anglersking/quadcopter/schematic/Altium_Design/PCB_PROJECT/rotor.DXF

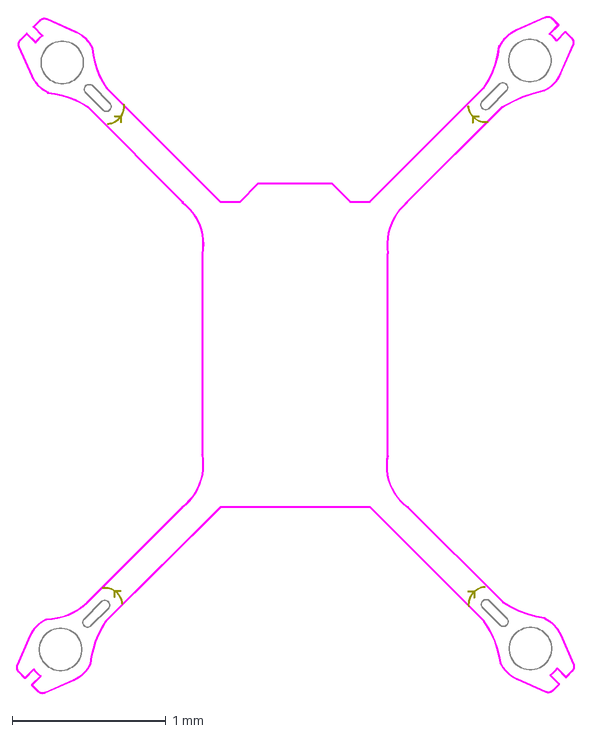
[picture p1: CAD file, 2024-02-03]
schematic/Altium_Design/PCB_PROJECT/rotor.DXF
3.63 x 4.41 mm
