anglersking/quadcopter/schematic/Altium_Design/四轴原理图/源动力-四轴 v1.9.5.pdf

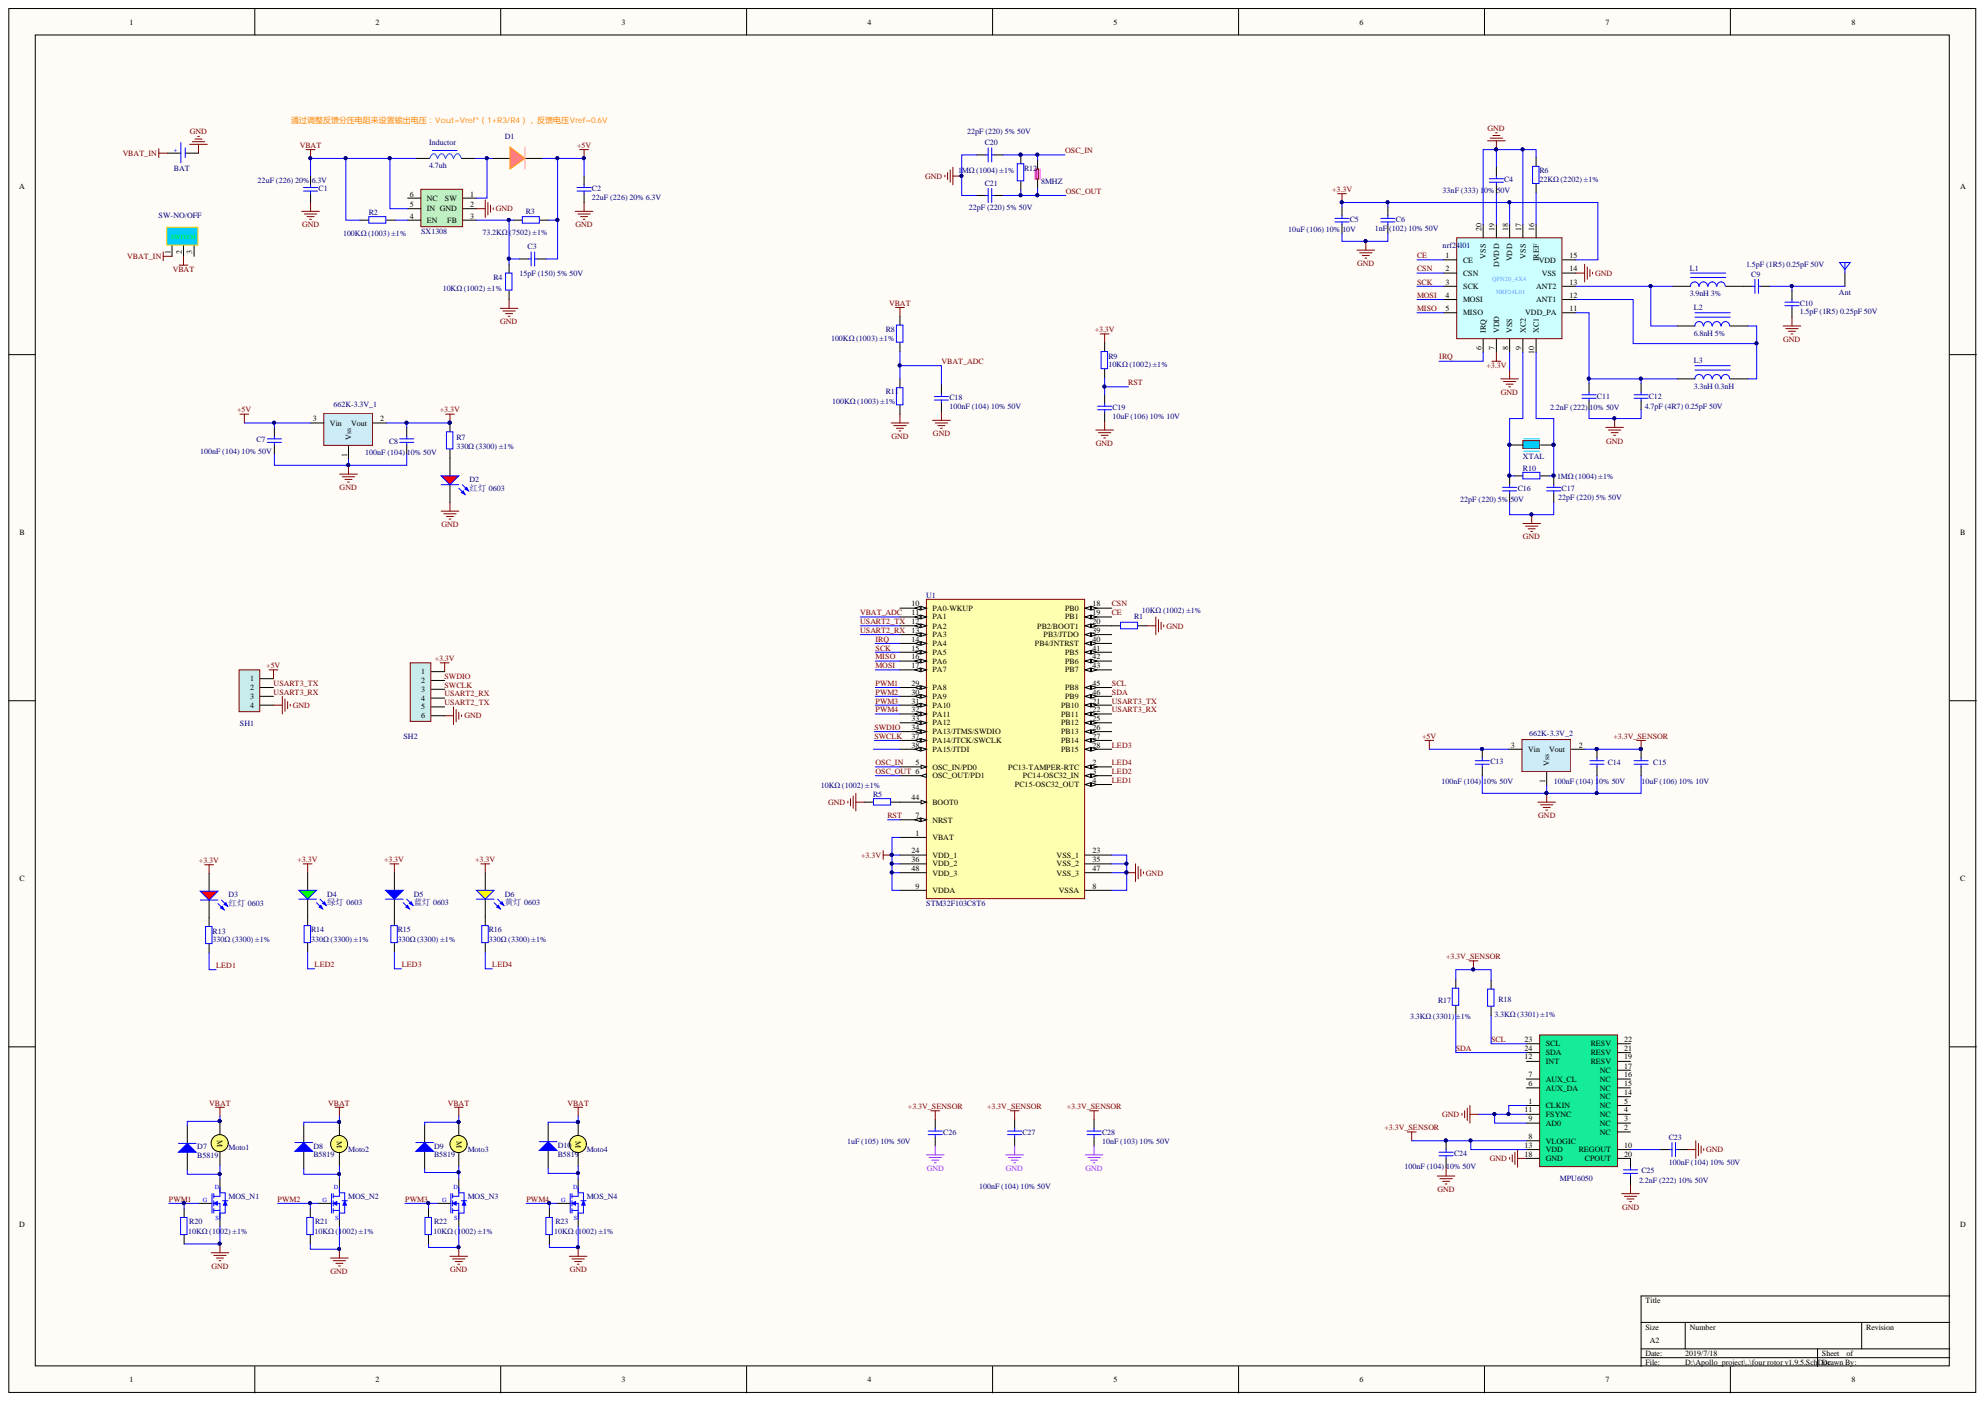
[picture p2: page 1]

通过调整反馈分压电阻来设置输出电压：Vout=Vref*（1+R3/R4），反馈电压Vref=0.6V
