anglersking/quadcopter/(list of files, drawings)

Other design files:
schematic/Altium_Design/PCB_PROJECT/cpu_core.SchDoc
schematic/Altium_Design/PCB_PROJECT/flow.SchDoc
schematic/Altium_Design/PCB_PROJECT/rotor.SchDoc
schematic/Altium_Design/PCB_PROJECT/SPL06.SchDoc
schematic/Altium_Design/自制3D元件封装库/self_schlib v1.8.6.SchLib
