anglersking/quadcopter/code/四轴飞行器/four rotor v1.8.6/four rotor/four rotor/driver/filter.h

#ifndef _filter_h_
#define _filter_h_

typedef struct
{
    float input_data[3];
    float output_data[3];
}_Butterworth_data;

typedef struct
{
    const float a[3];
    const float b[3];
}_Butterworth_parameter;

float butterworth_lpf(float now_input,_Butterworth_data *buffer, _Butterworth_parameter *parameter);


#endif
