anglersking/quadcopter/code/四轴飞行器/four rotor v1.8.6/four rotor/four rotor/driver/imath.c

#include "imath.h"

// Fast inverse square-root

float invSqrt(float x)
{
    float halfx = 0.5f * x;
    float y = x;
    long i = *(long*)&y;
    i = 0x5f3759df - (i>>1);
    y = *(float*)&i;
    y = y * (1.5f - (halfx * y * y));
    return y;
}


float my_abs(float f)
{
	if (f >= 0.0f)
	{
		return f;
	}

	return -f;
}


uint16_t  throttle_limit(uint16_t thr_in,uint16_t thr_min,uint16_t thr_max)
{
	if(thr_in<thr_min)	thr_in = thr_min;
	if(thr_in>thr_max)	thr_in = thr_max;
	
	return thr_in;
}

float direction_to_zero(float in_dat,float min_dat,float max_dat)
{
    if(in_dat>min_dat&&in_dat<max_dat)  
        in_dat = 0;
    
    return in_dat;
}

void  set_value(SI_F_XYZ *_in_data,float value)
{
    _in_data->x = value;
    _in_data->y = value;
    _in_data->z = value;
}

void _set_val(SI_F_XYZ *_out_data,SI_F_XYZ *_in_data)
{
    _out_data->x = _in_data->x;
    _out_data->y = _in_data->y;
    _out_data->z = _in_data->z;
}
