anglersking/quadcopter/code/四轴飞行器/four rotor v1.8.6/four rotor/four rotor/driver/imath.h

#ifndef _imath_h_
#define _imath_h_

#include "stm32f10x.h"
#include "mpu6050.h"

float invSqrt(float x);


float fast_atan2(float y, float x) ;


uint16_t  throttle_limit(uint16_t thr_in,uint16_t thr_min,uint16_t thr_max);
float direction_to_zero(float in_dat,float min_dat,float max_dat);
float my_abs(float f);

void  set_value(SI_F_XYZ *_in_data,float value);
void _set_val(SI_F_XYZ *_out_data,SI_F_XYZ *_in_data);

#endif
