anglersking/quadcopter/code/四轴飞行器/four rotor v1.8.6/four rotor/four rotor/driver/ist8310.h

#ifndef _ist8310_h_
#define _ist8310_h_


#include "stm32f10x.h"

#define IST8310_SLAVE_ADDRESS     0x0E<<1
#define IST8310_REG_STB           0x0C	//Self-Test response
#define IST8310_REG_INFO          0x01	//More Info
#define IST8310_REG_WIA           0x00	//Who I am
#define IST8310_REG_DATAX         0x03	//Output Value x
#define IST8310_REG_DATAY         0x05	//Output Value y
#define IST8310_REG_DATAZ         0x07	//Output Value z
#define IST8310_REG_STAT1         0x02	//Status register
#define IST8310_REG_STAT2         0x09	//Status register
#define IST8310_REG_CNTRL1        0x0A	//Control setting register 1
#define IST8310_REG_CNTRL2        0x0B	//Control setting register 2
#define IST8310_REG_CNTRL3        0x0D	//Control setting register 3
#define IST8310_REG_OFFSET_START  0xDC	//Offset
#define IST8310_REG_SELECTION_REG 0x42   //Sensor Selection register
#define IST8310_REG_TEST_REG      0x40   //Chip Test register
#define IST8310_REG_TUNING_REG    0x47    //Bandgap Tuning register

/*---IST8310 cross-axis matrix Address-----------------danny-----*/
#define IST8310_REG_XX_CROSS_L    0x9C  //cross axis xx low byte
#define IST8310_REG_XX_CROSS_H    0x9D  //cross axis xx high byte
#define IST8310_REG_XY_CROSS_L    0x9E  //cross axis xy low byte
#define IST8310_REG_XY_CROSS_H    0x9F  //cross axis xy high byte
#define IST8310_REG_XZ_CROSS_L    0xA0  //cross axis xz low byte
#define IST8310_REG_XZ_CROSS_H    0xA1  //cross axis xz high byte                         
#define IST8310_REG_YX_CROSS_L    0xA2  //cross axis yx low byte
#define IST8310_REG_YX_CROSS_H    0xA3  //cross axis yx high byte
#define IST8310_REG_YY_CROSS_L    0xA4  //cross axis yy low byte
#define IST8310_REG_YY_CROSS_H    0xA5  //cross axis yy high byte
#define IST8310_REG_YZ_CROSS_L    0xA6  //cross axis yz low byte
#define IST8310_REG_YZ_CROSS_H    0xA7  //cross axis yz high byte                   
#define IST8310_REG_ZX_CROSS_L    0xA8  //cross axis zx low byte
#define IST8310_REG_ZX_CROSS_H    0xA9  //cross axis zx high byte
#define IST8310_REG_ZY_CROSS_L    0xAA  //cross axis zy low byte
#define IST8310_REG_ZY_CROSS_H    0xAB  //cross axis zy high byte
#define IST8310_REG_ZZ_CROSS_L    0xAC  //cross axis zz low byte
#define IST8310_REG_ZZ_CROSS_H    0xAD  //cross axis zz high byte
#define IST8310_AXES_NUM          3


typedef struct 
{
	signed short x;
	signed short y;
	signed short z;    
}_S16_UNIT_XYZ;

typedef struct 
{
    _S16_UNIT_XYZ data;    
    _S16_UNIT_XYZ offset;
    float   thx;
    float   thy;
    float   angle;
}_IST8310;

void IST8310_init(void);
void get_ist_raw(void);
void get_ist_data(void);

extern _IST8310 ist;

#endif
