anglersking/quadcopter/code/四轴飞行器/four rotor v1.8.6/four rotor/four rotor/driver/nvic.c

#include "nvic.h"


void NVIC_config(void)
{
    NVIC_InitTypeDef NVIC_InitStructure;    

    NVIC_PriorityGroupConfig(NVIC_PriorityGroup_2);             //优先级组别2

    //飞控任务调度定时器中断
	NVIC_InitStructure.NVIC_IRQChannel = TIM3_IRQn;    
	NVIC_InitStructure.NVIC_IRQChannelPreemptionPriority = 1;               
    NVIC_InitStructure.NVIC_IRQChannelSubPriority = 0;
	NVIC_InitStructure.NVIC_IRQChannelCmd = ENABLE;            
	NVIC_Init(&NVIC_InitStructure);                            
    
    //光流数据接收中断
    NVIC_InitStructure.NVIC_IRQChannel = USART3_IRQn;
    NVIC_InitStructure.NVIC_IRQChannelPreemptionPriority = 0;
    NVIC_InitStructure.NVIC_IRQChannelSubPriority = 0;
    NVIC_InitStructure.NVIC_IRQChannelCmd = ENABLE;
    NVIC_Init(&NVIC_InitStructure);
}
