anglersking/quadcopter/(commit log)

2023-09-11 add doc
    [self_schlib v1.8.6.SchLib]
2023-09-11 add sch from pads
    [Four_Motor.sch, self_schlib v1.8.6.SchLib]
2023-09-11 add sch pads and AD
    [Four_Motor.sch, PCB1.PcbDoc, rotor.PrjPcb, rotor.SchDoc, self_schlib v1.8.6.SchLib]
